feaser/canfdshield/(commit log)

2025-05-14 Initial import.
    [canfdshield.kicad_pcb, canfdshield.kicad_sch]
2025-05-14 Rough component positioning on the board.
    [canfdshield.kicad_pcb]
2025-05-14 Reshaped board outline.
    [canfdshield.kicad_pcb]
2025-05-14 Updated shield connectors from socket to header and flipped them.
    [canfdshield.kicad_pcb, canfdshield.kicad_sch]
2025-05-14 Assigned LCSC part numbers to the pin row headers.
    [canfdshield.kicad_sch]
2025-05-14 Completed signal routing.
    [canfdshield.kicad_pcb]
2025-05-14 Added some details to the silkscreen.
    [canfdshield.kicad_pcb, canfdshield.kicad_sch]
2025-05-14 Added tooling holes and jlcjlcjlcjlc placeholder.
    [canfdshield.kicad_pcb]
2025-05-14 Removed no longer needed mounting hole footprint.
    [canfdshield.kicad_pcb]
2025-05-14 Added assembly and Gerber files.
    [canfdshield-BOM.csv, canfdshield-Footprint-Positions.csv, canfdshield.kicad_pcb, canfdshield.kicad_sch]
2025-05-15 Changed LED to a basic 0805 part and added the 4-pin header for non-Arduino boards.
    [canfdshield.kicad_pcb, canfdshield.kicad_sch]
2025-05-15 Updated Gerbers and assembly files.
    [canfdshield-BOM.csv, canfdshield-Footprint-Positions.csv]
